koushikkamble76-oss/Smart_shopping_trolley/Circuit Design .jpg

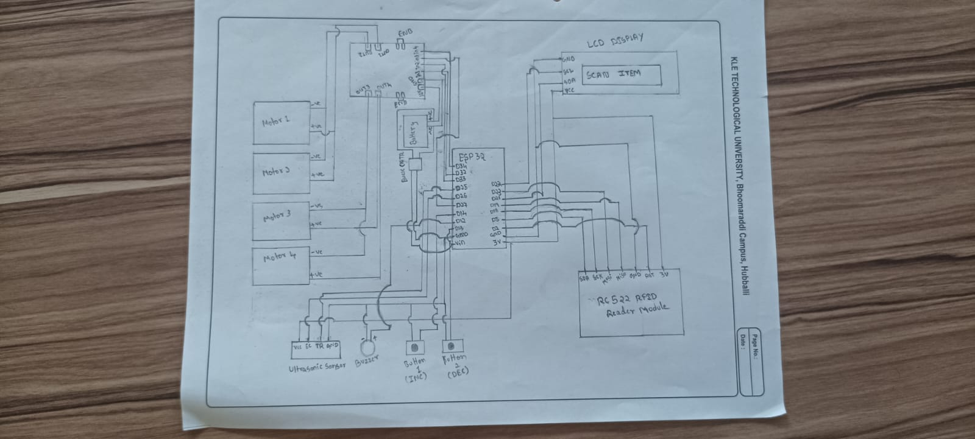
Circuit Design .jpg
