koushikkamble76-oss/Smart_shopping_trolley/README.md

# 🛒 NextGen Smart Shopping Cart  

## 📌 Theme: Automation for Human Well-Being  
Automation has transformed human life by improving **convenience, efficiency, and safety**.  
Our project focuses on integrating **intelligent systems** to reduce human effort and improve daily tasks, healthcare, industries, and retail.  

**Key Benefits of Automation for Human Well-Being:**  
- ✅ Reduces human effort & fatigue  
- ✅ Increases accessibility (elderly & differently-abled)  
- ✅ Improves accuracy & consistency  
- ✅ Saves time & cost  
- ✅ Enhances safety and quality of life  

---

## ❗ Problem Identification  
Traditional shopping is inefficient due to:  
- Long queues at billing counters  
- Manual scanning of items  
- Difficulty in budget management  
- Challenges for elderly, pregnant women, and differently-abled shoppers  

**Proposed Solution:** Smart Shopping Cart with **automatic billing, RFID scanning, obstacle detection, and mobile app integration**.  

---

## 💡 Design Thinking Approach  
We followed a **5-step design thinking process**:  
1. **Empathize** – Understanding users’ needs  
2. **Define** – Clear problem statement  
3. **Ideate** – Brainstorming multiple solutions  
4. **Prototype** – Building low-cost functional models  
5. **Test** – Refining with user feedback  

---

## 👥 Stakeholders  
- **Primary:** Customers (elderly, hand-impaired, carrying women)  
- **Secondary:** Store managers & workers  
- **Tertiary:** Project team & mentors  

---

## 🔑 User Needs  
The cart should:  
- Be mobile-controlled  
- Identify items using RFID/Scanner  
- Display **real-time bill** on LCD screen  
- Detect obstacles & stop automatically  
- Help manage **shopping budget**  
- Allow **easy removal of items**  
- Follow customers autonomously  

---

## ⚙️ System Design  
**Technologies Used:**  
- **RFID & IR Sensors** – Item scanning & obstacle detection  
- **ESP32/Arduino** – Control unit  
- **LCD Display** – Real-time billing info  
- **DC/Stepper Motors** – Actuation & movement  
- **Mobile App** – Remote control & budget alerts  

**Concept Evaluation:**  
- Selected **Design 2** as the final prototype (highest score in usability, cost, and efficiency).  

---

## 🛠 Prototype & Testing  
**Implemented Features:**  
- RFID-based item scanning  
- Automatic billing system  
- Obstacle detection with ultrasonic sensors  
- Mobile app integration  

**Limitations Identified:**  
- Struggled on uneven floors  
- Expired product detection not implemented  

---

## ✅ Conclusion  
The **NextGen Smart Shopping Cart** enhances shopping by:  
- Automating billing  
- Providing real-time budget tracking  
- Improving accessibility for special-needs users  
- Reducing checkout delays  

Future improvements: **better floor adaptability, expired product detection, unauthorized item alerts**.  

---

---

## 📊 GitHub Stats (for profile README)  
GitHub stats  
Top Languages
