koushikkamble76-oss/Smart_shopping_trolley/Board Images.jpg

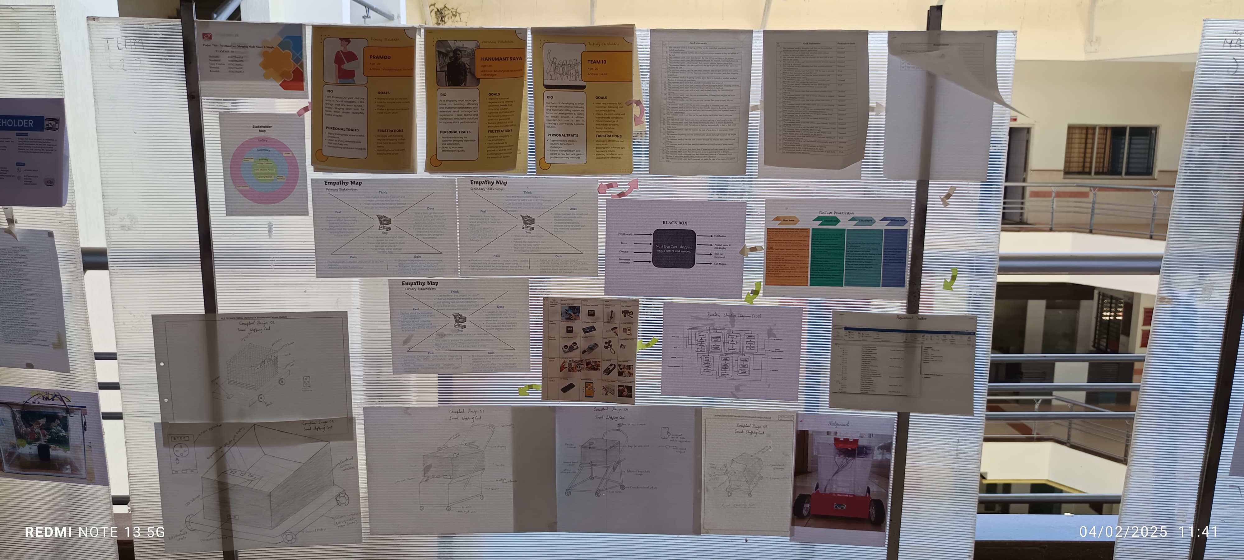
Board Images.jpg
