koushikkamble76-oss/Smart_shopping_trolley/MATLAB_Arch/WhatsApp Image 2025-02-03 at 23.15.31_5e50f237.jpg

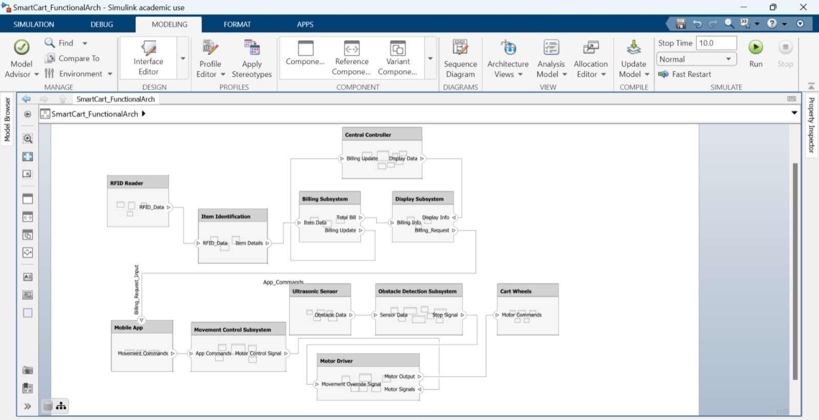
MATLAB_Arch/WhatsApp Image 2025-02-03 at 23.15.31_5e50f237.jpg
