koushikkamble76-oss/Smart_shopping_trolley/MATLAB_Requirments/WhatsApp Image 2025-02-03 at 23.15.12_b5f6a271.jpg

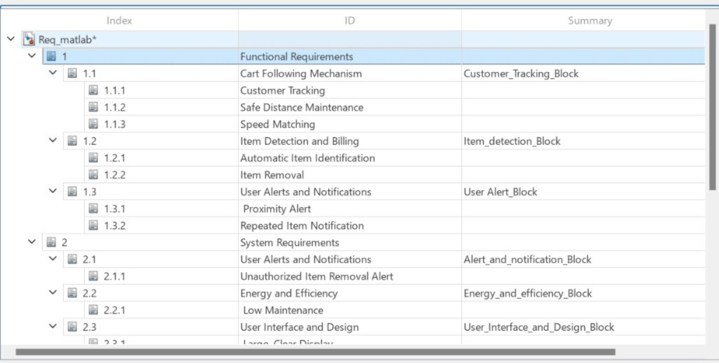
MATLAB_Requirments/WhatsApp Image 2025-02-03 at 23.15.12_b5f6a271.jpg
