koushikkamble76-oss/Smart_shopping_trolley/Solidworks_files/New folder/buzzer-23.snapshot.1/Buzzer.JPG

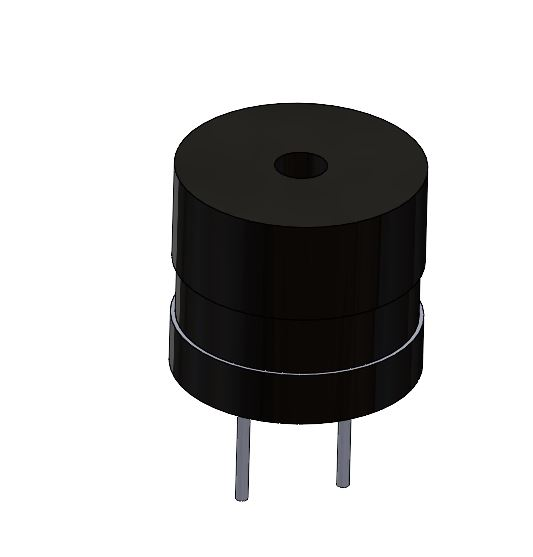
Solidworks_files/New folder/buzzer-23.snapshot.1/Buzzer.JPG
