koushikkamble76-oss/Smart_shopping_trolley/Solidworks_files/New folder/Drafting Images/Assem1.JPG

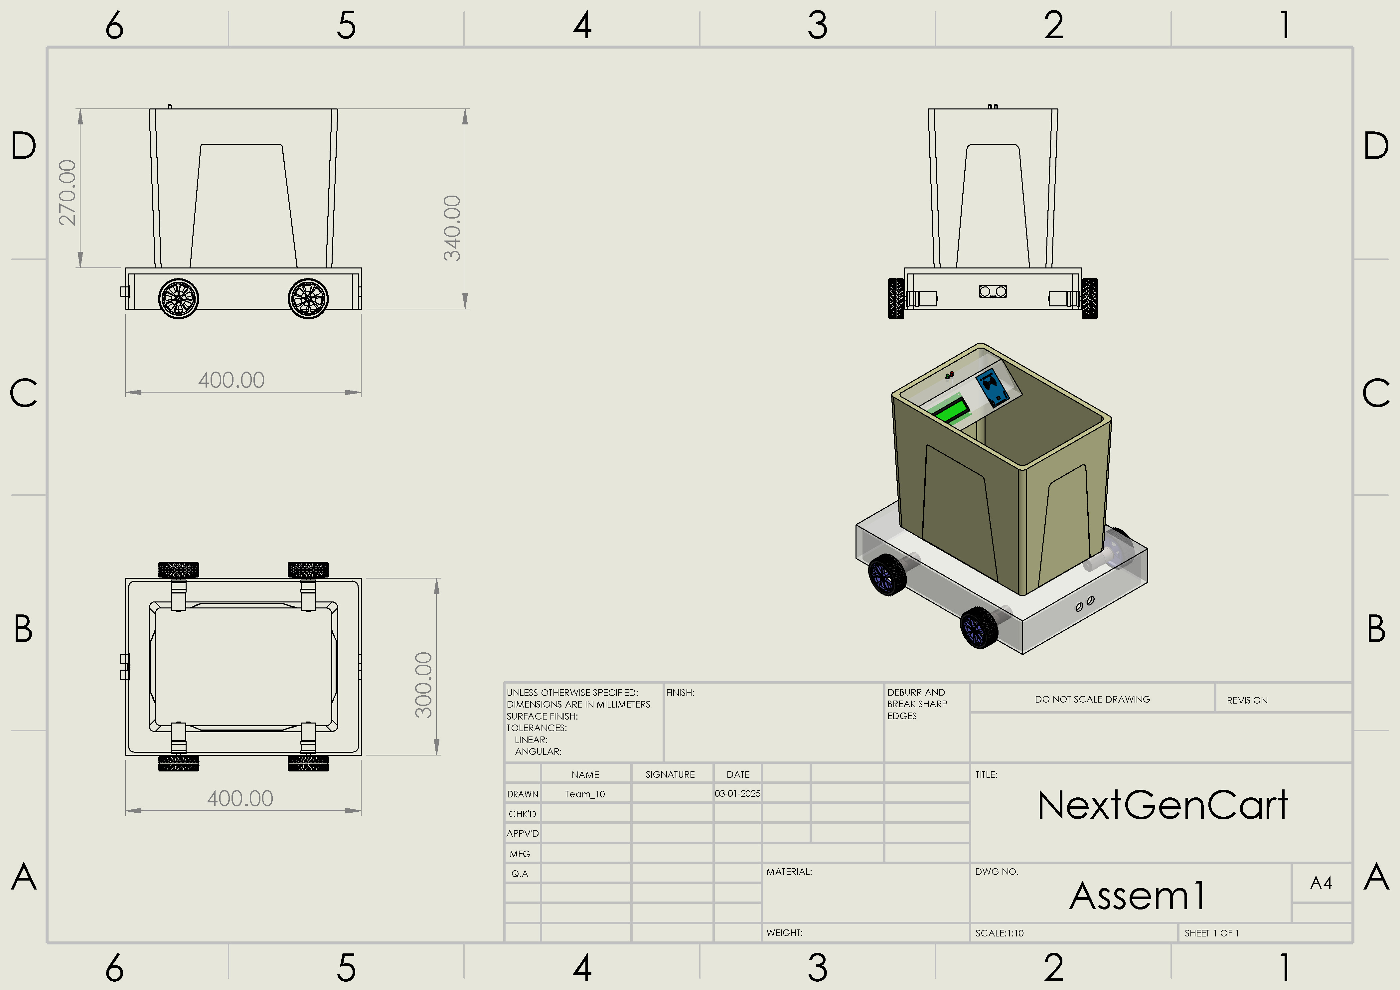
Solidworks_files/New folder/Drafting Images/Assem1.JPG
