koushikkamble76-oss/Smart_shopping_trolley/Solidworks_files/New folder/Draftting/Assem2.JPG

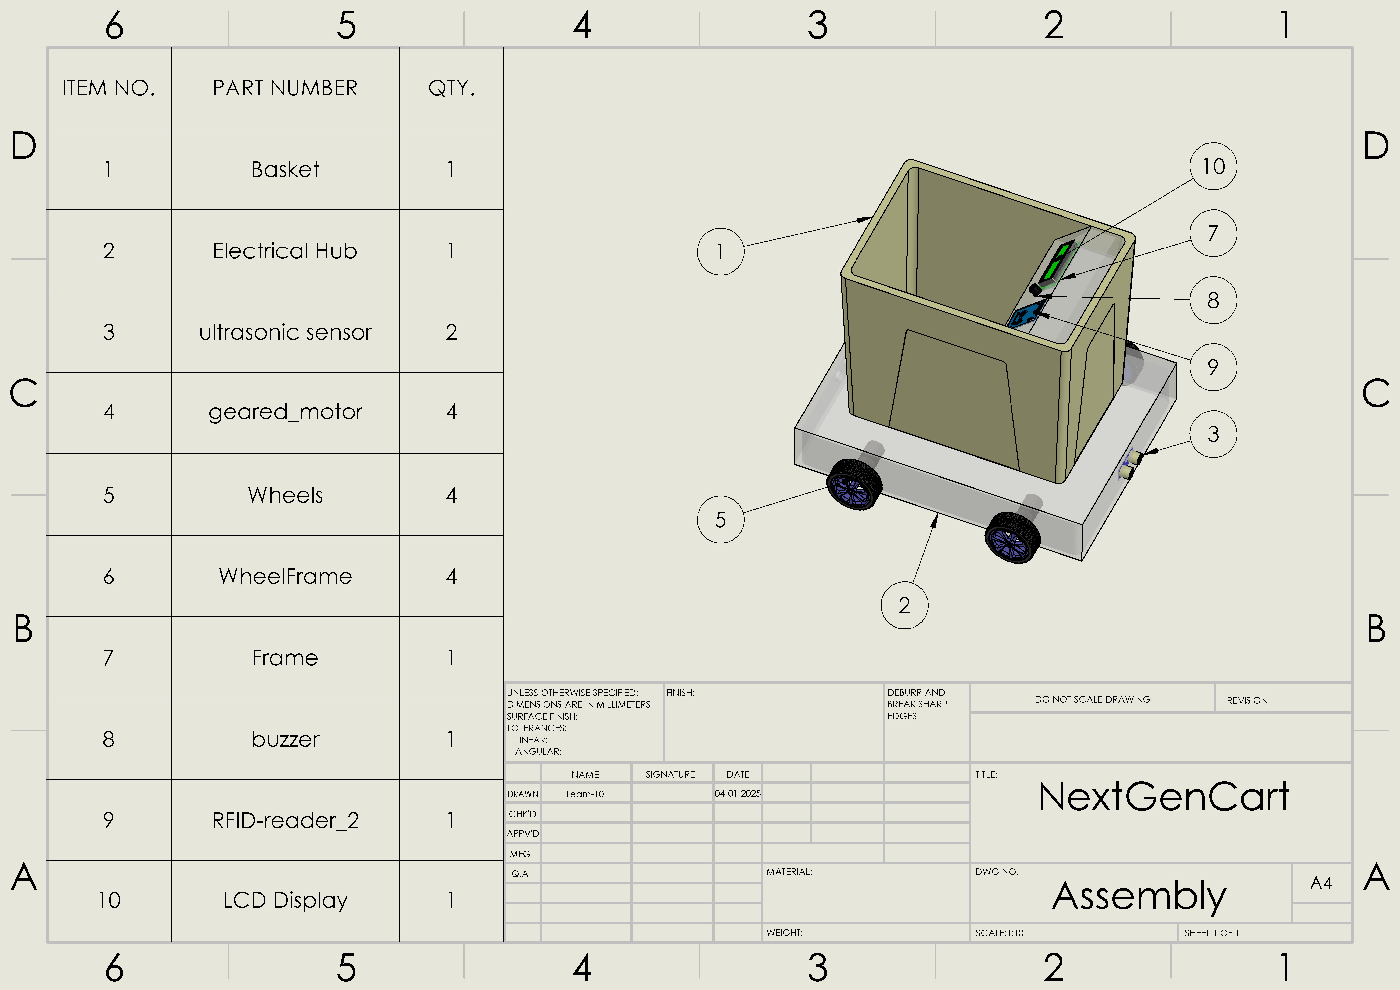
Solidworks_files/New folder/Draftting/Assem2.JPG
