koushikkamble76-oss/Smart_shopping_trolley/Solidworks_files/New folder/Images/Assem.png

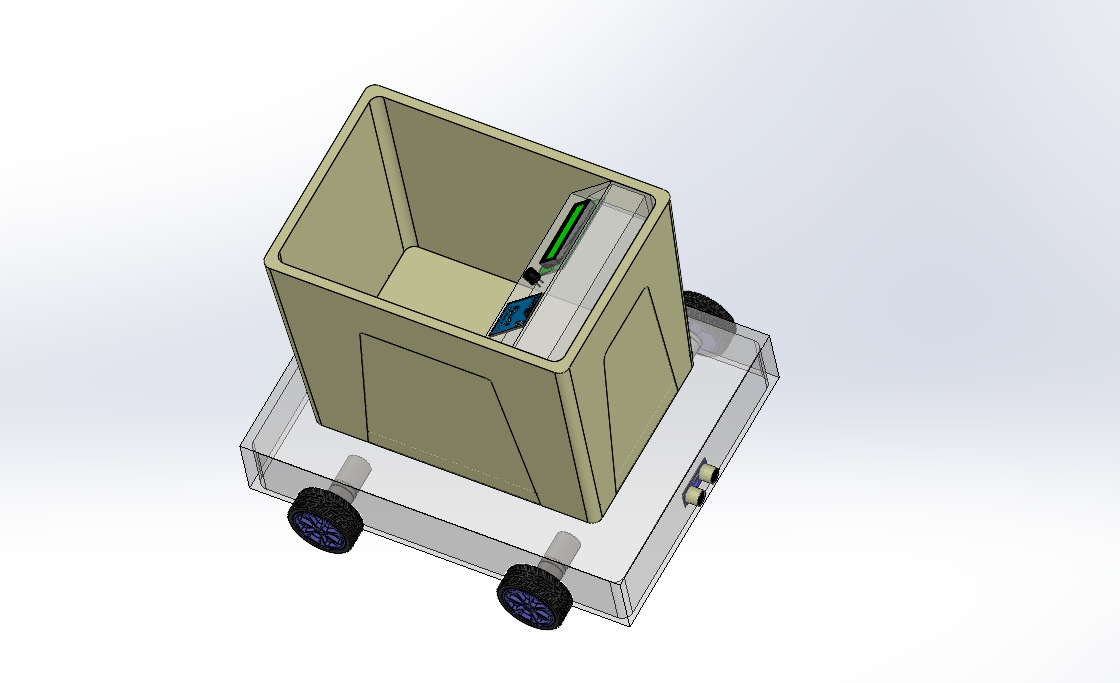
Solidworks_files/New folder/Images/Assem.png
