koushikkamble76-oss/Smart_shopping_trolley/Solidworks_files/New folder/Images/Basket.png

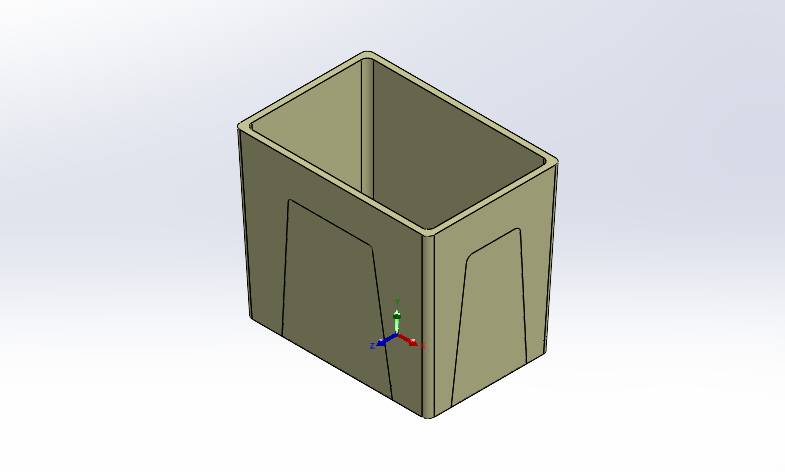
Solidworks_files/New folder/Images/Basket.png
