koushikkamble76-oss/Smart_shopping_trolley/Solidworks_files/New folder/Images/Electrical Hub.png

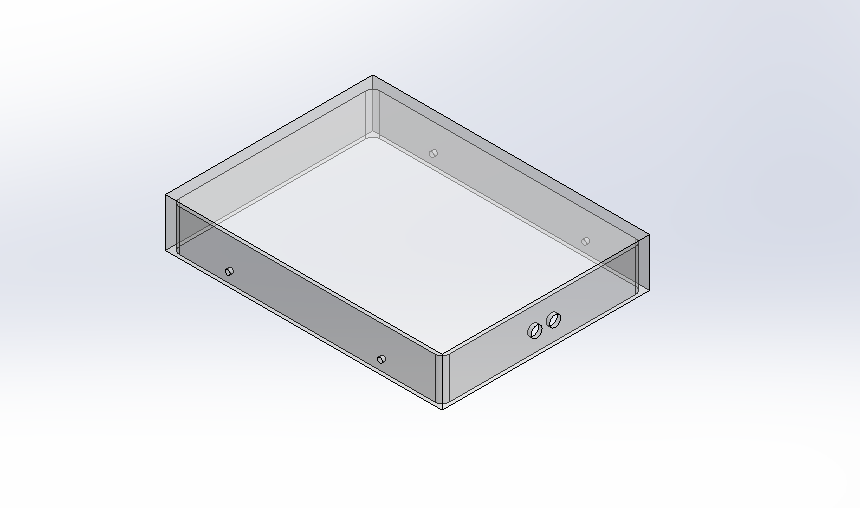
Solidworks_files/New folder/Images/Electrical Hub.png
