koushikkamble76-oss/Smart_shopping_trolley/Solidworks_files/New folder/Images/Geared Motor.png

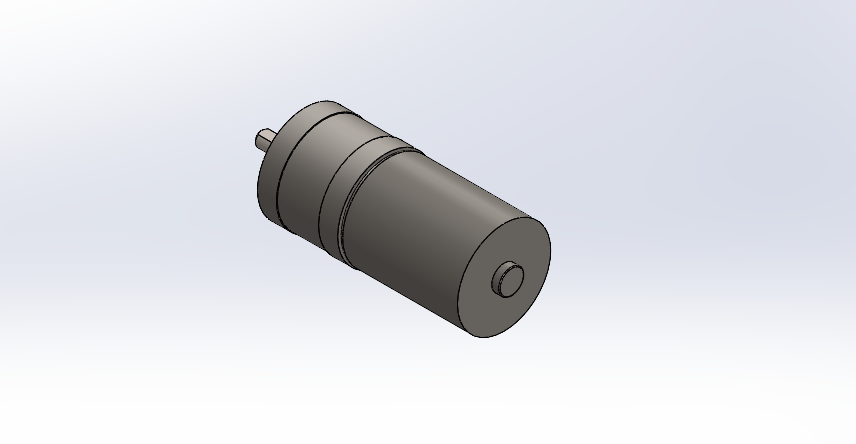
Solidworks_files/New folder/Images/Geared Motor.png
