koushikkamble76-oss/Smart_shopping_trolley/Solidworks_files/New folder/Images/Screenshot 2025-01-04 113804.png

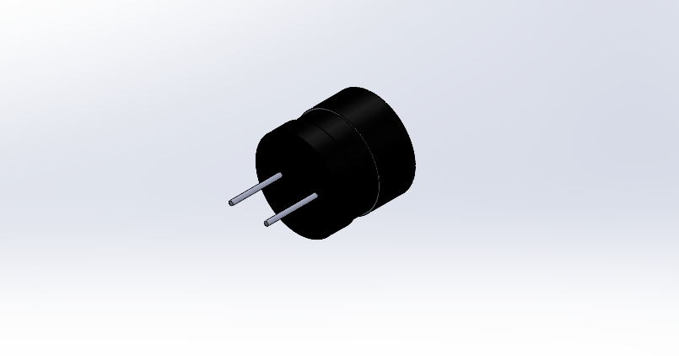
Solidworks_files/New folder/Images/Screenshot 2025-01-04 113804.png
