koushikkamble76-oss/Smart_shopping_trolley/Solidworks_files/New folder/Images/Ultrasonic Sensor.png

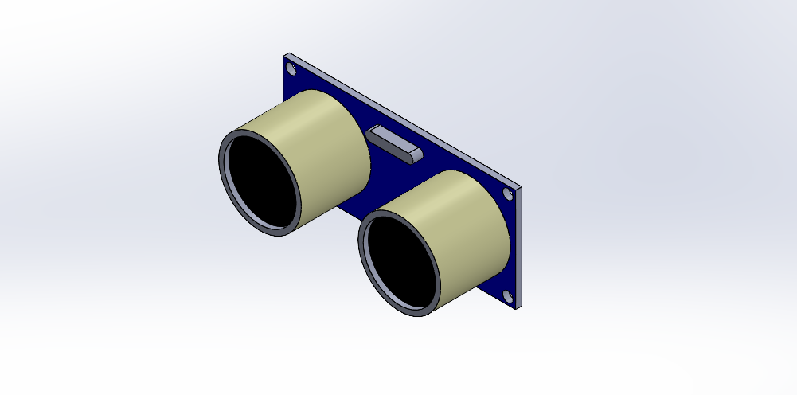
Solidworks_files/New folder/Images/Ultrasonic Sensor.png
