koushikkamble76-oss/Smart_shopping_trolley/working_videos & Pictures/IMG-20250202-WA0003.jpg

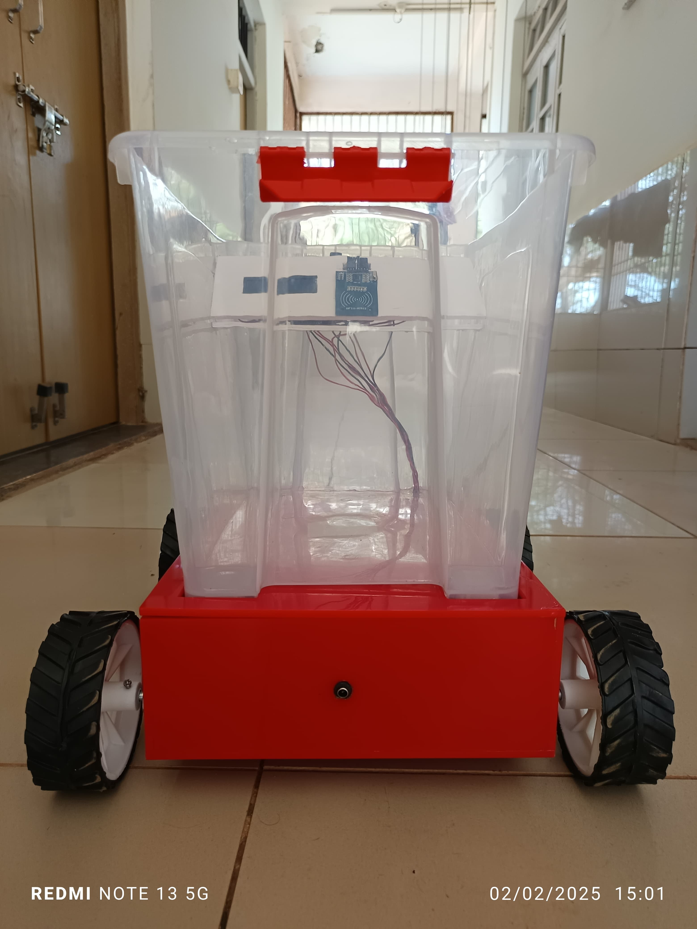
working_videos & Pictures/IMG-20250202-WA0003.jpg
