koushikkamble76-oss/Smart_shopping_trolley/working_videos & Pictures/IMG-20250202-WA0006.jpg

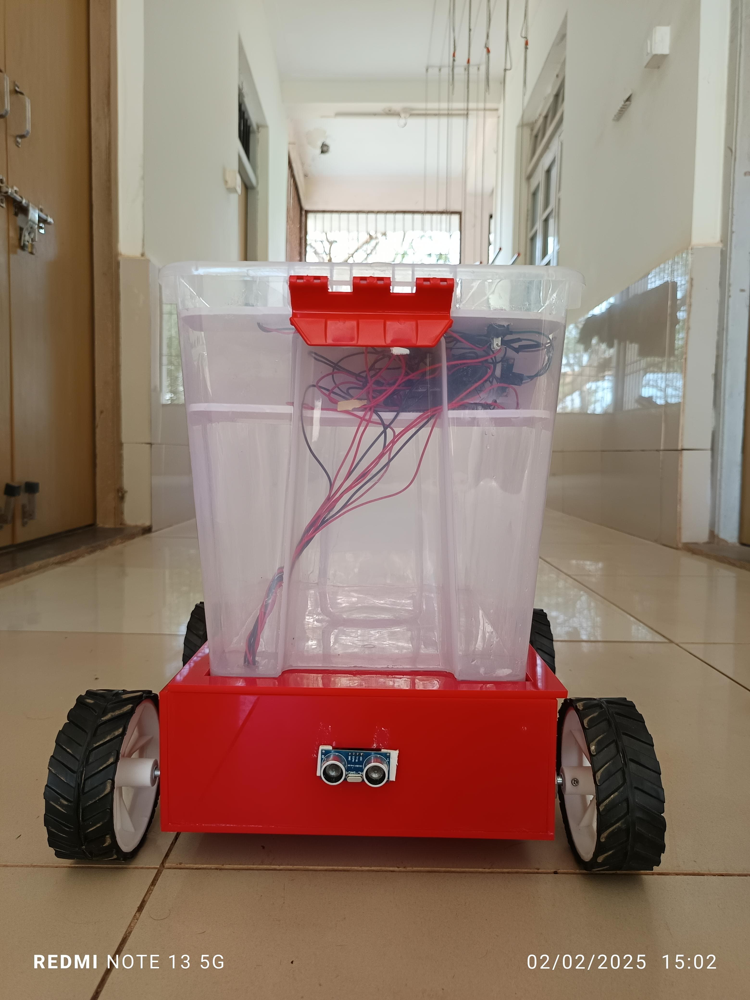
working_videos & Pictures/IMG-20250202-WA0006.jpg
