koushikkamble76-oss/Smart_shopping_trolley/Solidworks_files/New folder/Draftting/BOM.JPG

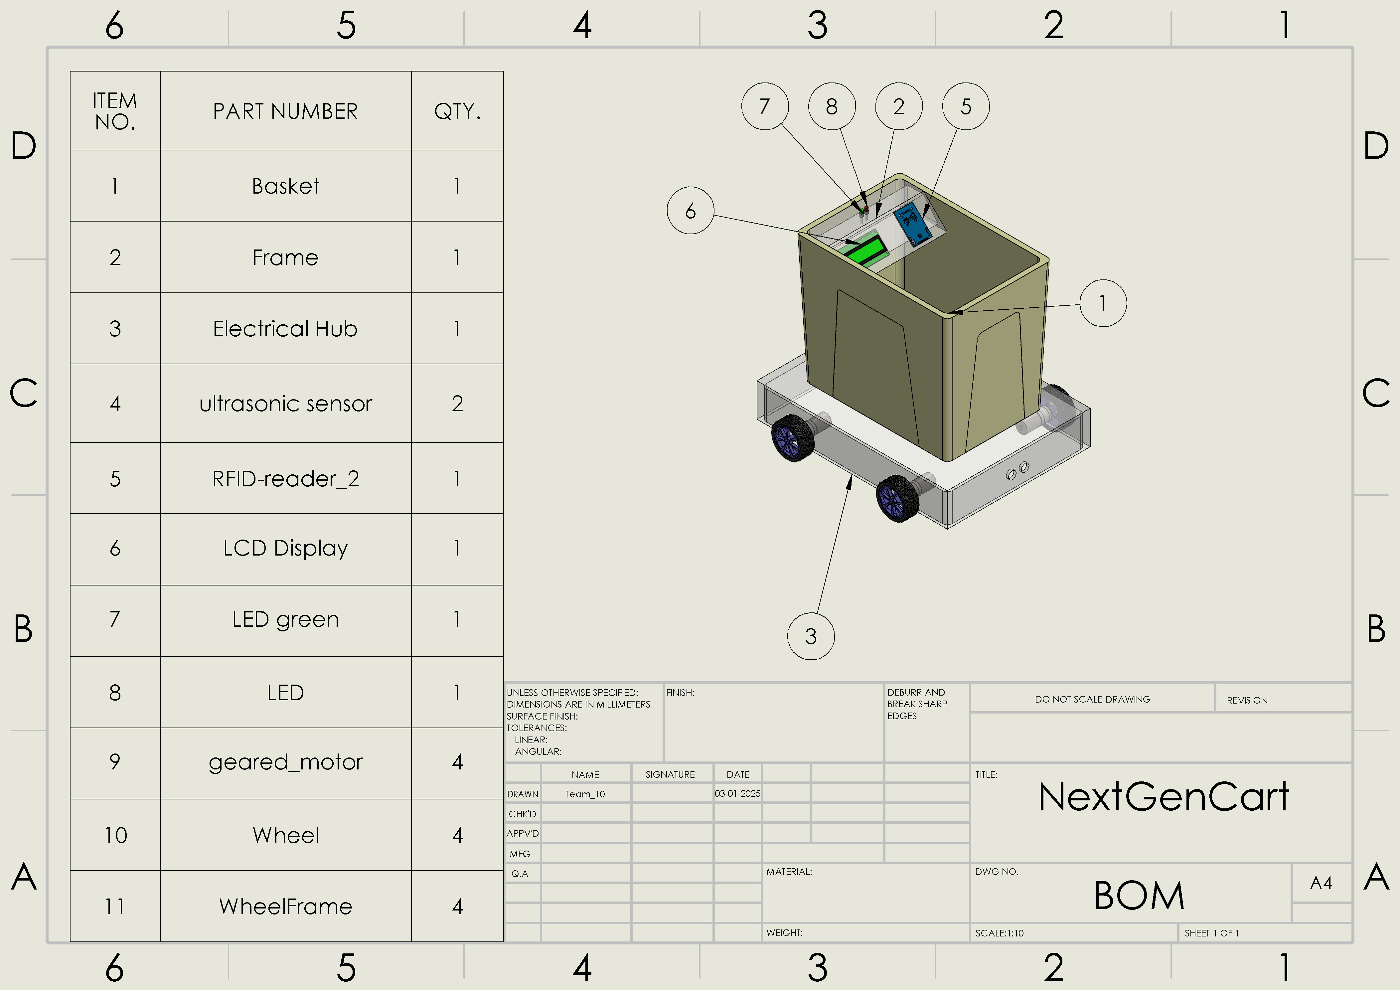
Solidworks_files/New folder/Draftting/BOM.JPG
