koushikkamble76-oss/Smart_shopping_trolley/Solidworks_files/New folder/Robot wheel with motor and bracket/Wheel Assemble simmetry.SLDASM

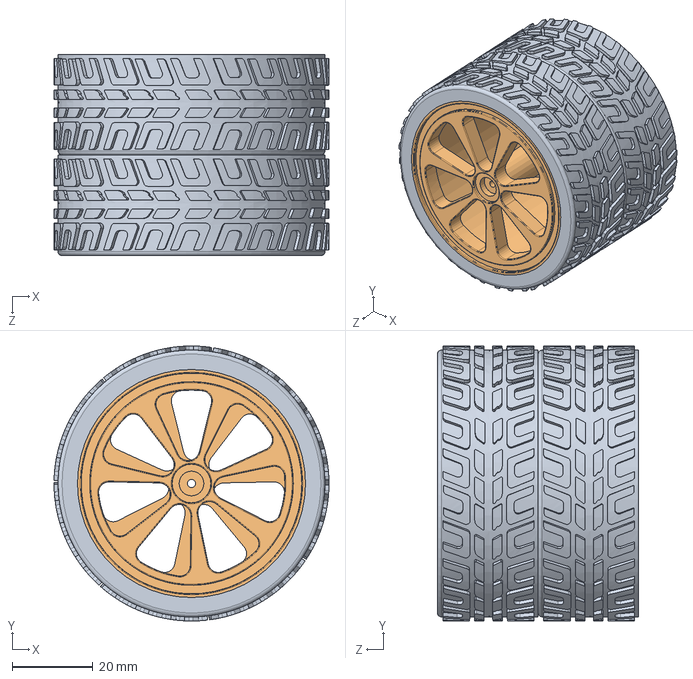
[picture p103: CAD file, 2025-09-01]
Solidworks_files/New folder/Robot wheel with motor and bracket/Wheel Assemble simmetry.SLDASM
68.0 x 68.0 x 49.8 mm
WheelFrame
Tire
