koushikkamble76-oss/Smart_shopping_trolley/Solidworks_files/New folder/Acrylic Sheet/Assem2.SLDASM

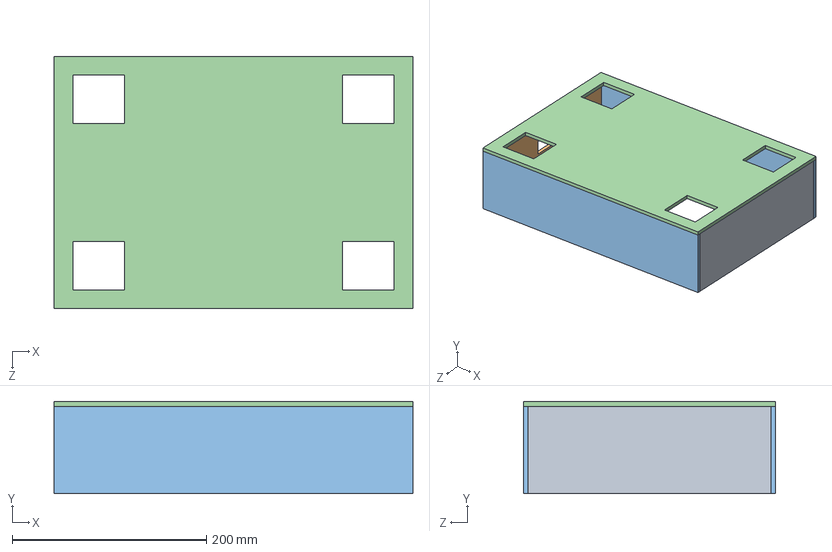
[picture p104: CAD file, 2025-09-01]
Solidworks_files/New folder/Acrylic Sheet/Assem2.SLDASM
370.0 x 95.0 x 260.0 mm
