koushikkamble76-oss/Smart_shopping_trolley/Solidworks_files/New folder/Assem2.SLDASM

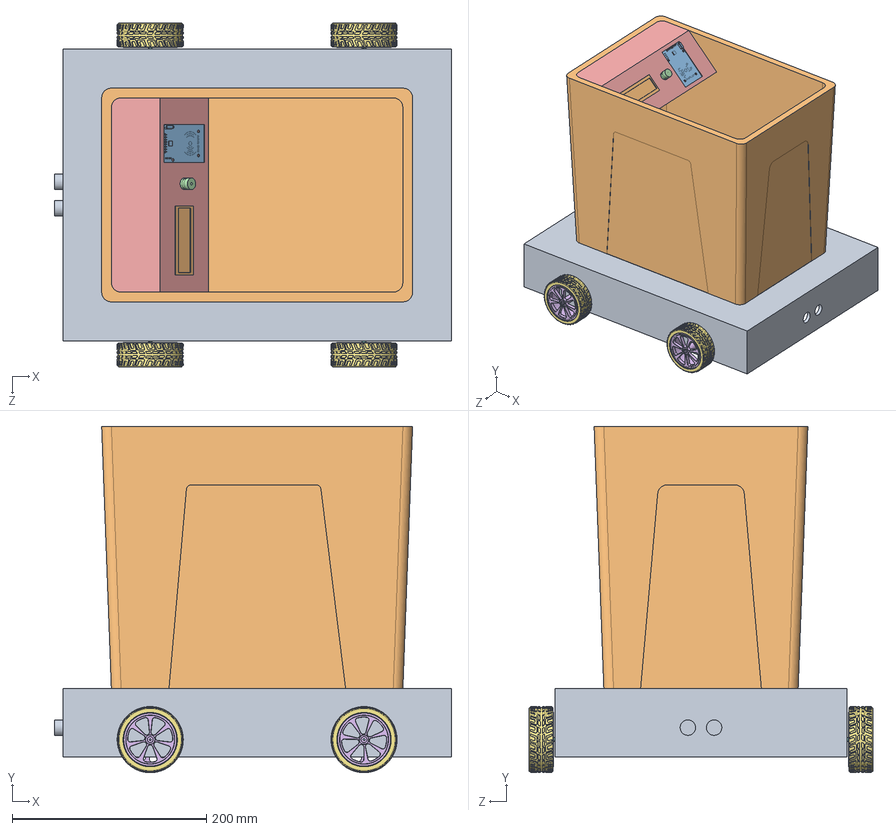
[picture p105: CAD file, 2025-09-01]
Solidworks_files/New folder/Assem2.SLDASM
408.5 x 356.3 x 354.0 mm
Basket
Frame
geared_motor x 4
Tire x 4
WheelFrame x 4
buzzer
RFID-reader_2
LCD Display
ultrasonic sensor
