koushikkamble76-oss/Smart_shopping_trolley/Solidworks_files/New folder/Assem3.SLDASM

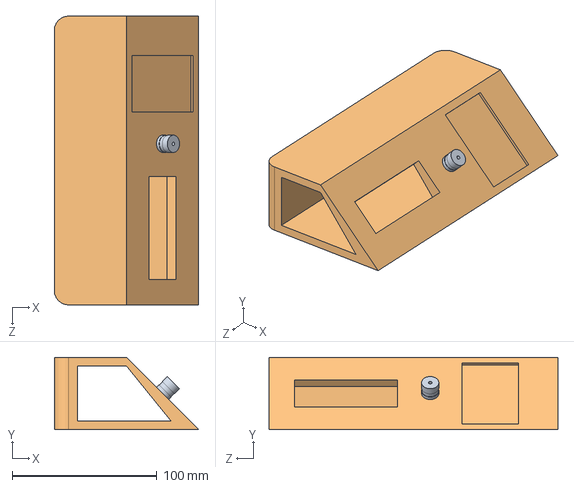
[picture p106: CAD file, 2025-09-01]
Solidworks_files/New folder/Assem3.SLDASM
100.0 x 50.0 x 200.0 mm
buzzer
