koushikkamble76-oss/Smart_shopping_trolley/Solidworks_files/New folder/Robot wheel with motor and bracket/Wheel Assemble.SLDASM

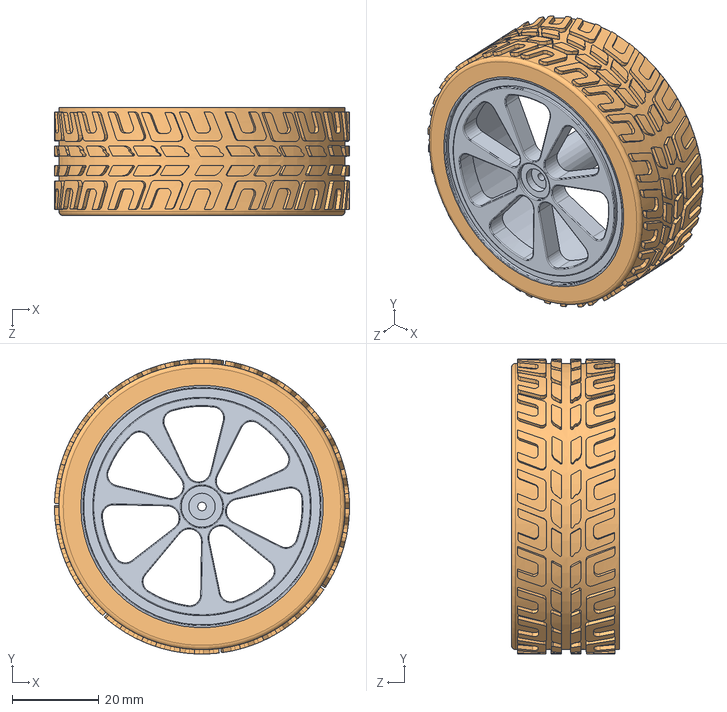
[picture p107: CAD file, 2025-09-01]
Solidworks_files/New folder/Robot wheel with motor and bracket/Wheel Assemble.SLDASM
68.0 x 68.0 x 25.0 mm
Tire
WheelFrame
