koushikkamble76-oss/Smart_shopping_trolley/Solidworks_files/New folder/Acrylic Sheet/Assem1.SLDASM

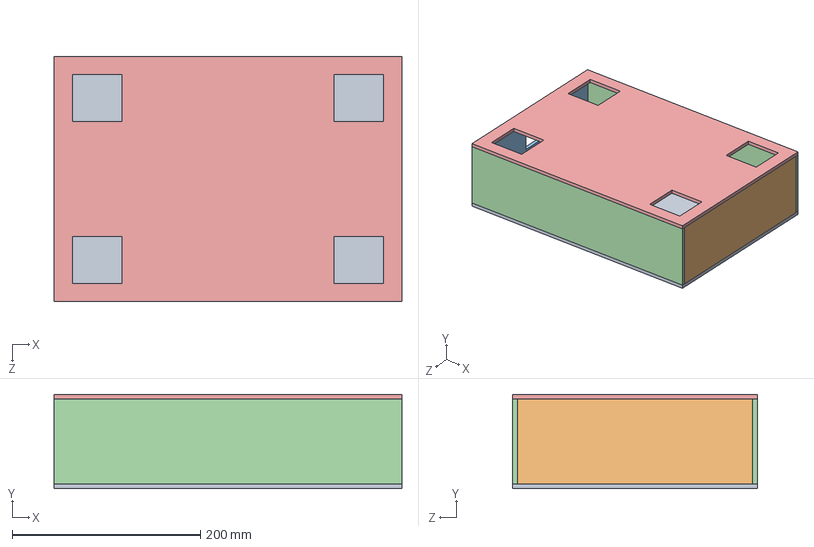
[picture p108: CAD file, 2025-09-01]
Solidworks_files/New folder/Acrylic Sheet/Assem1.SLDASM
370.0 x 100.0 x 260.0 mm
bottom
