koushikkamble76-oss/Smart_shopping_trolley/Solidworks_files/New folder/Acrylic Sheet/part 3.SLDPRT

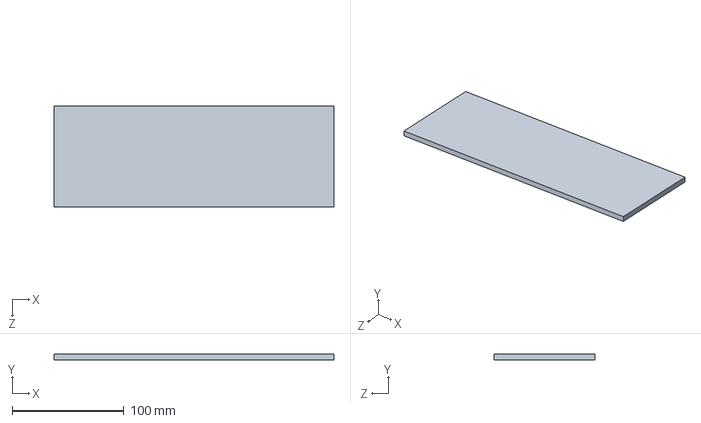
[picture p109: CAD file, 2025-09-01]
Solidworks_files/New folder/Acrylic Sheet/part 3.SLDPRT
250.0 x 5.00 x 90.0 mm
