koushikkamble76-oss/Smart_shopping_trolley/Solidworks_files/New folder/buzzer-23.snapshot.1/buzzer.SLDPRT

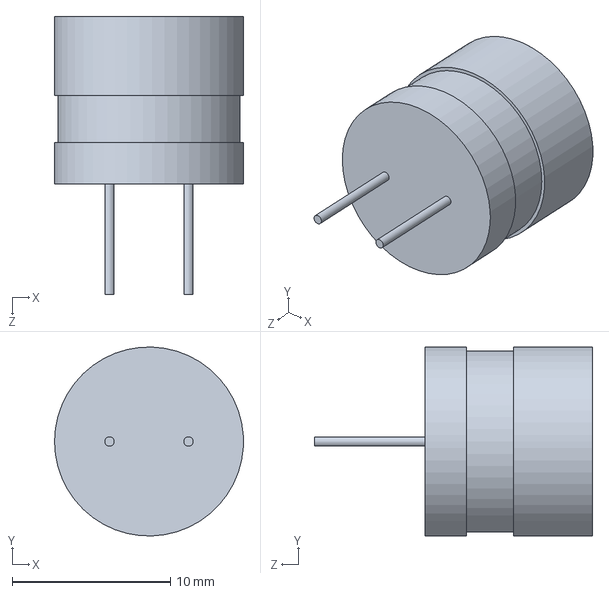
[picture p110: CAD file, 2025-09-01]
Solidworks_files/New folder/buzzer-23.snapshot.1/buzzer.SLDPRT
12.0 x 12.0 x 17.6 mm
