koushikkamble76-oss/Smart_shopping_trolley/Solidworks_files/New folder/Robot wheel with motor and bracket/Tire.SLDPRT

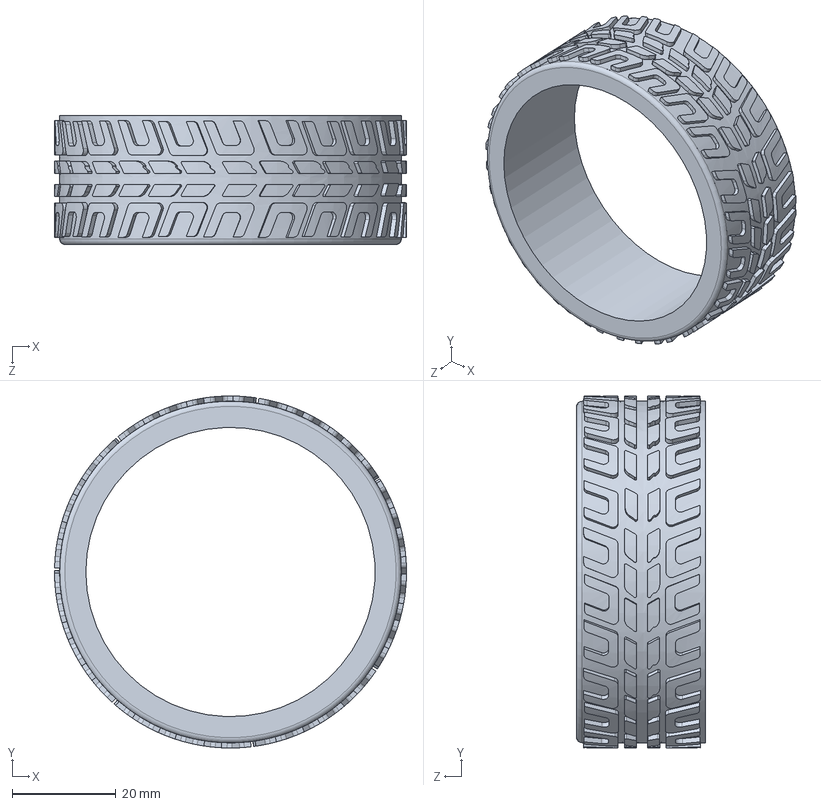
[picture p111: CAD file, 2025-09-01]
Solidworks_files/New folder/Robot wheel with motor and bracket/Tire.SLDPRT
68.0 x 68.0 x 24.9 mm
