koushikkamble76-oss/Smart_shopping_trolley/Solidworks_files/New folder/Robot wheel with motor and bracket/WheelFrame.SLDPRT

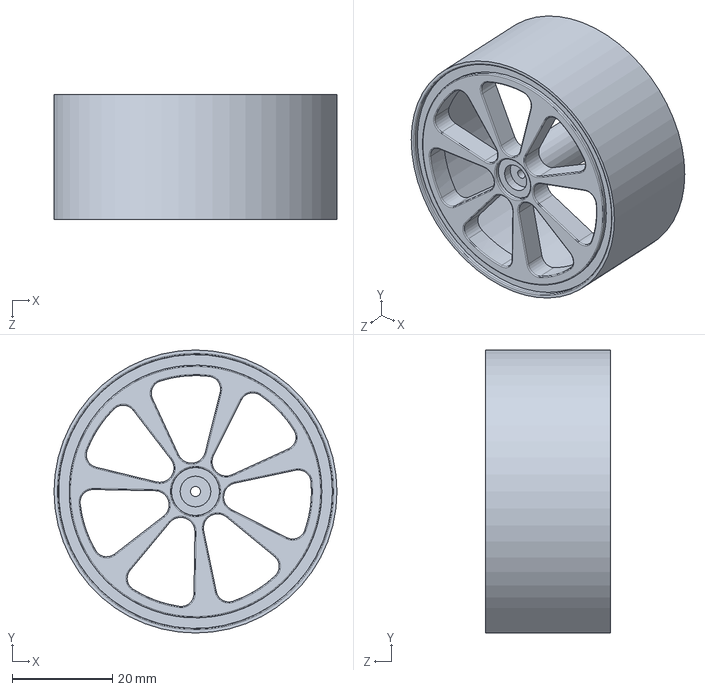
[picture p112: CAD file, 2025-09-01]
Solidworks_files/New folder/Robot wheel with motor and bracket/WheelFrame.SLDPRT
56.4 x 56.4 x 25.0 mm
