koushikkamble76-oss/Smart_shopping_trolley/Solidworks_files/New folder/ultrasonic sensor.SLDPRT

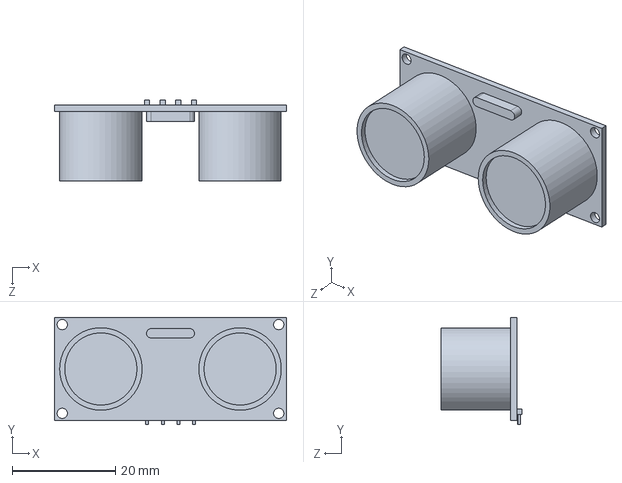
[picture p113: CAD file, 2025-09-01]
Solidworks_files/New folder/ultrasonic sensor.SLDPRT
45.0 x 20.8 x 15.7 mm
