koushikkamble76-oss/Smart_shopping_trolley/Solidworks_files/New folder/Frame.SLDPRT

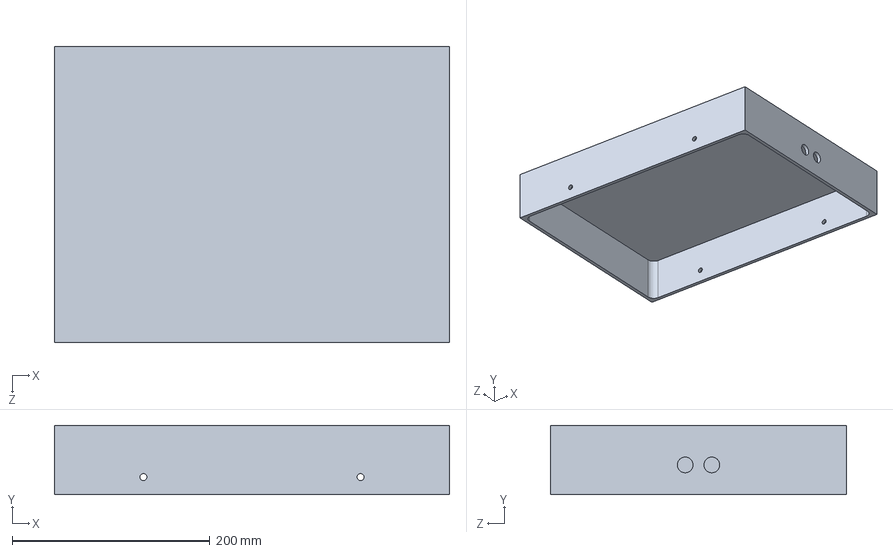
[picture p115: CAD file, 2025-09-01]
Solidworks_files/New folder/Frame.SLDPRT
400.0 x 70.0 x 300.0 mm
