koushikkamble76-oss/Smart_shopping_trolley/Solidworks_files/New folder/Robot wheel with motor and bracket/MotorBracket.SLDPRT

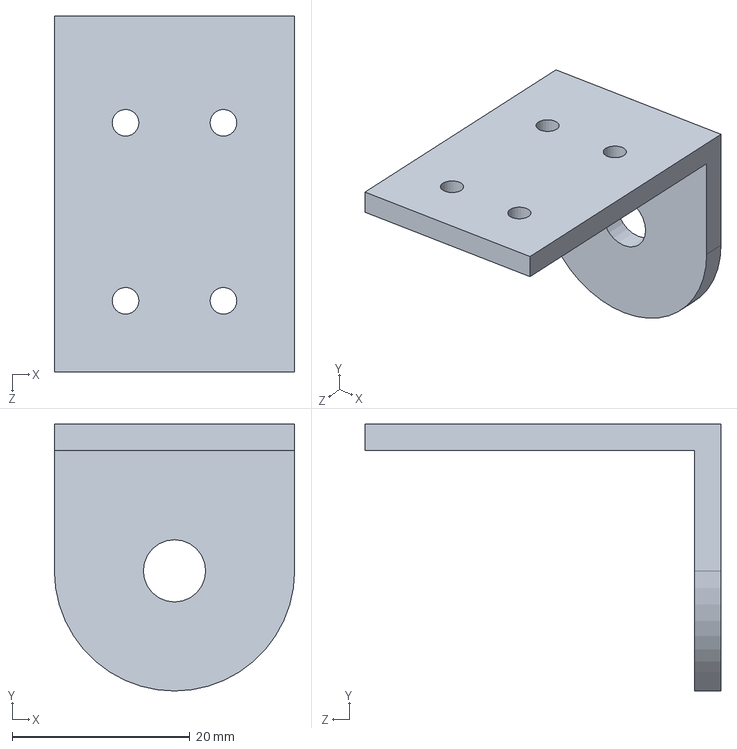
[picture p116: CAD file, 2025-09-01]
Solidworks_files/New folder/Robot wheel with motor and bracket/MotorBracket.SLDPRT
27.0 x 30.0 x 40.0 mm
