koushikkamble76-oss/Smart_shopping_trolley/Solidworks_files/New folder/Acrylic Sheet/Part 1.SLDPRT

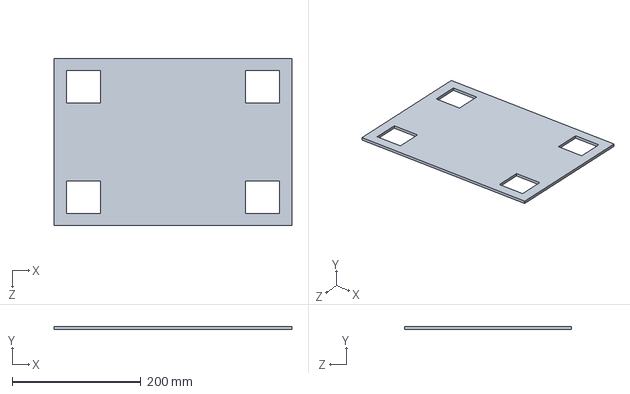
[picture p117: CAD file, 2025-09-01]
Solidworks_files/New folder/Acrylic Sheet/Part 1.SLDPRT
370.0 x 5.00 x 260.0 mm
