koushikkamble76-oss/Smart_shopping_trolley/Solidworks_files/New folder/Acrylic Sheet/Part copy.SLDPRT

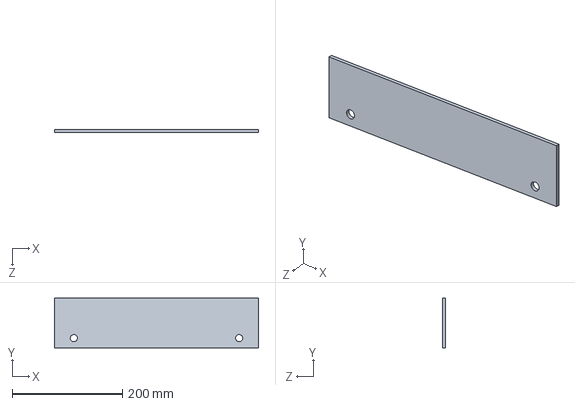
[picture p118: CAD file, 2025-09-01]
Solidworks_files/New folder/Acrylic Sheet/Part copy.SLDPRT
370.0 x 90.0 x 5.00 mm
