koushikkamble76-oss/Smart_shopping_trolley/Solidworks_files/New folder/LED green.SLDPRT

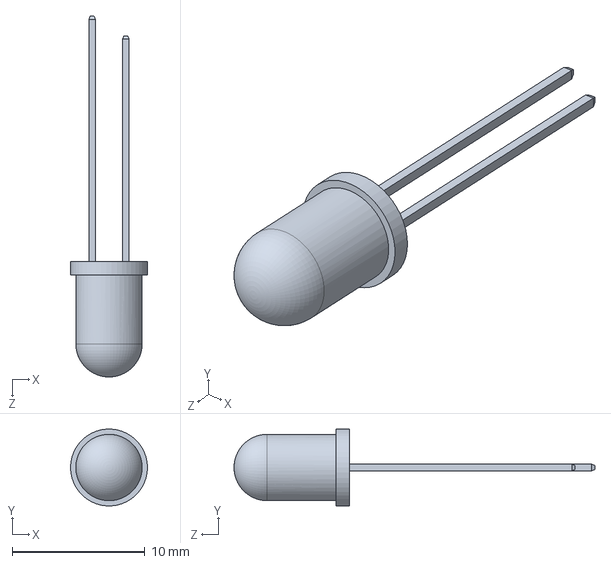
[picture p119: CAD file, 2025-09-01]
Solidworks_files/New folder/LED green.SLDPRT
5.80 x 5.79 x 27.2 mm
