koushikkamble76-oss/Smart_shopping_trolley/Solidworks_files/New folder/RFID-reader_2.SLDPRT

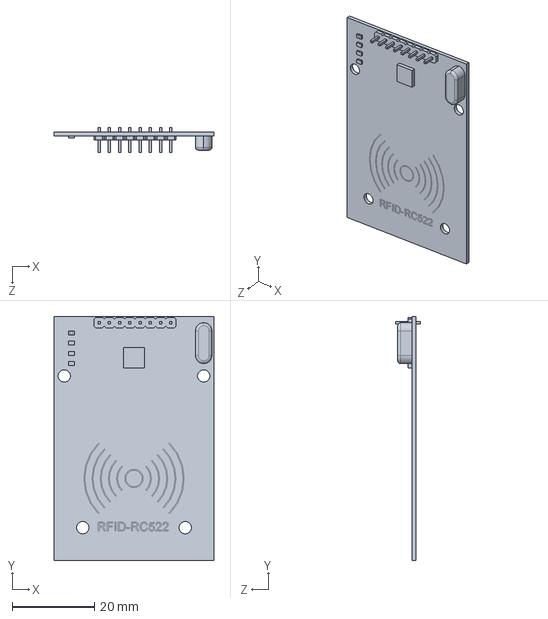
[picture p120: CAD file, 2025-09-01]
Solidworks_files/New folder/RFID-reader_2.SLDPRT
39.0 x 59.5 x 6.00 mm
