koushikkamble76-oss/Smart_shopping_trolley/Solidworks_files/New folder/Basket.SLDPRT

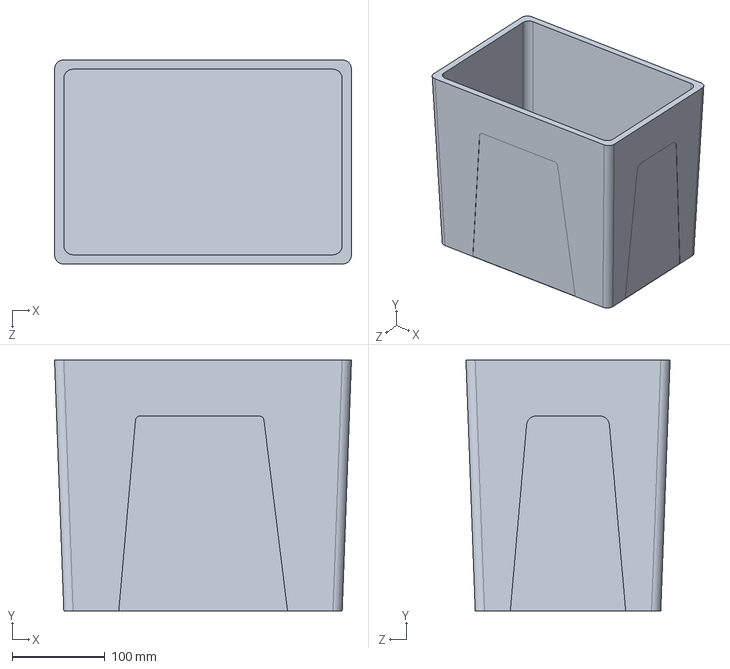
[picture p121: CAD file, 2025-09-01]
Solidworks_files/New folder/Basket.SLDPRT
320.0 x 270.0 x 220.0 mm
