koushikkamble76-oss/Smart_shopping_trolley/Solidworks_files/New folder/LCD.step

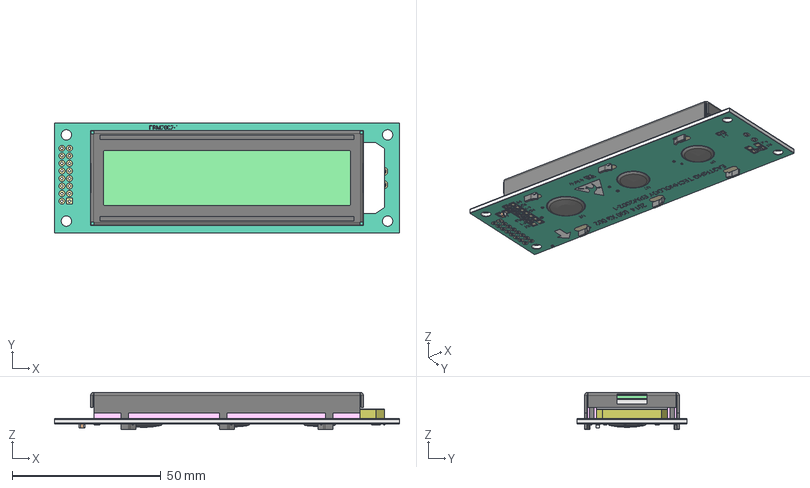
[picture p122: CAD file, 2025-09-01]
Solidworks_files/New folder/LCD.step
116.0 x 37.0 x 12.5 mm
Board
Metal_upper
Mask_upper
Frame
ShapeString
Metal_bottom
Mask_bottom
pin013
label007
ShapeString007
pin014
pin011
label006
ShapeString006
pin012
pin015
label008
ShapeString008
pin016
pin017
label009
ShapeString009
pin018
pin019
label010
ShapeString010
pin020
pin021
label011
ShapeString011
pin022
contact015
contact016
ShapeString003
pin023
label012
ShapeString012
pin024
U1
U2
U3
EASTRING
R001
R002
R003
R004
R005
R006
R007
R008
RF
C1
U001
U002
U003
RJ
94V-0
Ring001
Ring002
Ring003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
