koushikkamble76-oss/Smart_shopping_trolley/Solidworks_files/New folder/LCD Display.SLDPRT

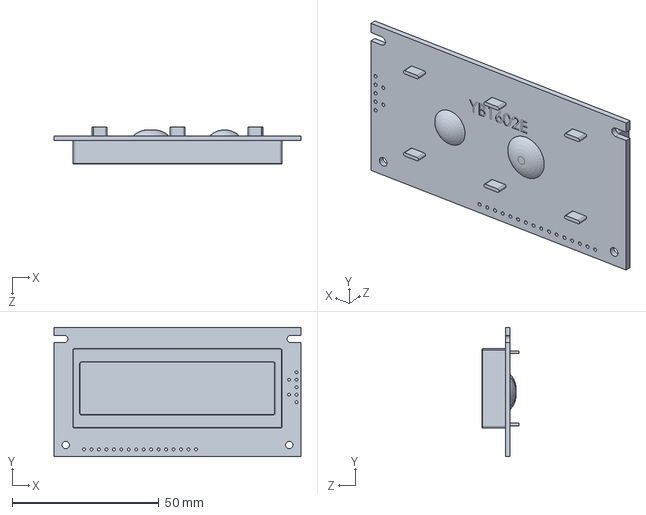
[picture p123: CAD file, 2025-09-01]
Solidworks_files/New folder/LCD Display.SLDPRT
84.1 x 44.0 x 12.6 mm
