koushikkamble76-oss/Smart_shopping_trolley/Solidworks_files/New folder/geared_motor.SLDPRT

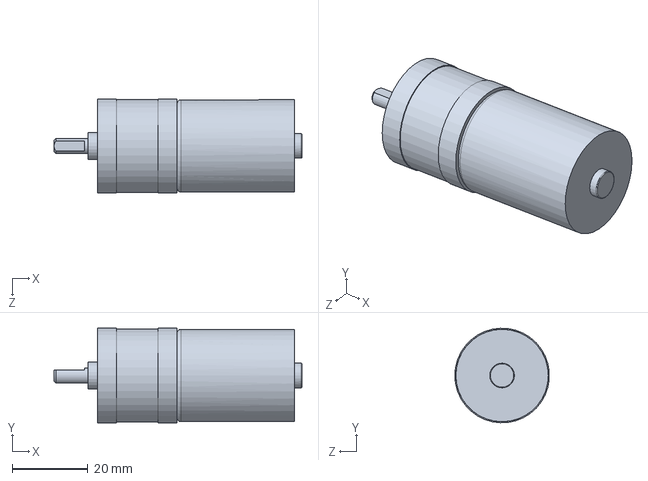
[picture p124: CAD file, 2025-09-01]
Solidworks_files/New folder/geared_motor.SLDPRT
65.5 x 25.0 x 25.0 mm
