koushikkamble76-oss/Smart_shopping_trolley/(list of files, cad)

Other CAD files:
Solidworks_files/New folder/Assem1.SLDASM
Solidworks_files/New folder/Part3.SLDPRT
Solidworks_files/New folder/Acrylic Sheet/Part4.SLDPRT
Solidworks_files/New folder/Acrylic Sheet/Part2.SLDPRT
Solidworks_files/New folder/LED.SLDPRT
Solidworks_files/New folder/Acrylic Sheet/Part 1.DXF
Solidworks_files/New folder/Acrylic Sheet/Part copy.DXF
Solidworks_files/New folder/Acrylic Sheet/Part2.DXF
Solidworks_files/New folder/Acrylic Sheet/Part4.DXF
Solidworks_files/New folder/Acrylic Sheet/bottom.DXF
Solidworks_files/New folder/Acrylic Sheet/part 3.DXF
Solidworks_files/New folder/Draftting/Assem2.SLDDRW
Solidworks_files/New folder/Draftting/BOM.SLDDRW
Solidworks_files/New folder/Draftting/Base Frame.SLDDRW
Solidworks_files/New folder/Draftting/Basket.SLDDRW
Solidworks_files/New folder/Draftting/Display Support.SLDDRW
Solidworks_files/New folder/Draftting/Geared Motor.SLDDRW
Solidworks_files/New folder/Draftting/LCD Display.SLDDRW
Solidworks_files/New folder/Draftting/Side Frame.SLDDRW
Solidworks_files/New folder/Draftting/Top Frame.SLDDRW
Solidworks_files/New folder/Draftting/Ultrasonic Sensor.SLDDRW
Solidworks_files/New folder/Draftting/buzzer.SLDDRW
